Finnix-Enterprises/00001-2-HAR-A-01/README.md

# 00001-2-HAR-A-01
Loan Scam buster Device
