Finnix-Enterprises/00001-2-HAR-A-01/PCB_Deliverables/3-PDF/BD-00001-A-01.pdf

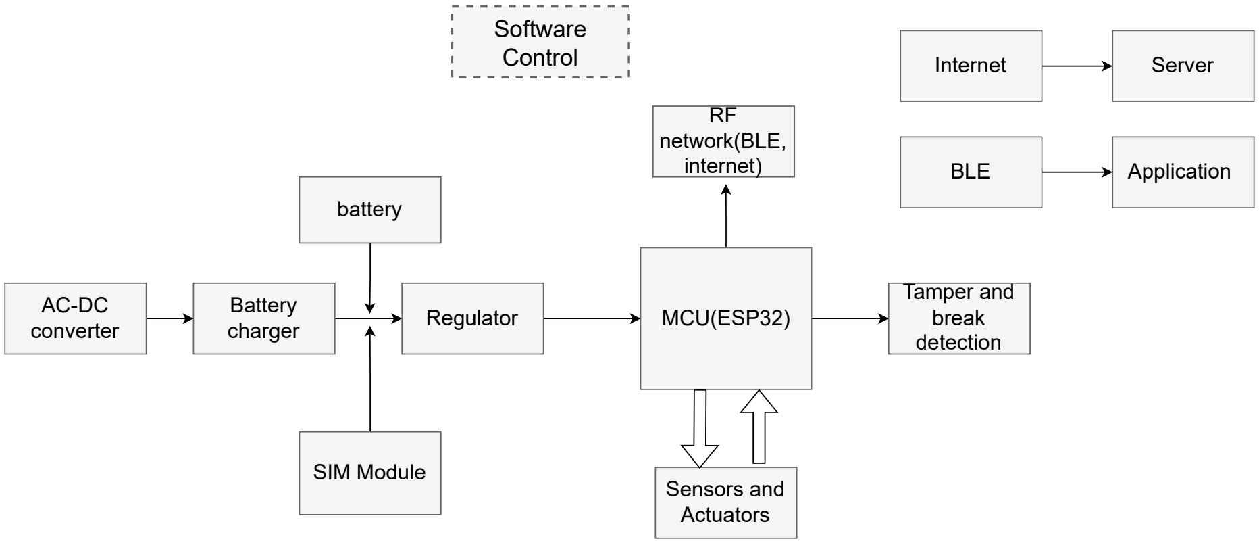
[picture p8: figure]
Software Control; RF network(BLE,; internet); BLE; Application; SIM Module; Sensors and Actuators; Regulator; MCU(ESP32) Battery; charger; battery; AC-DC converter; Tamper and break detection; Internet; Server
