Finnix-Enterprises/00001-2-HAR-A-01/PCB_Deliverables/3-PDF/STACK-00001-A-01.pdf

| A | B | C | D | E | F
4 | | | | | | | 4

## PCB LAYER STACK

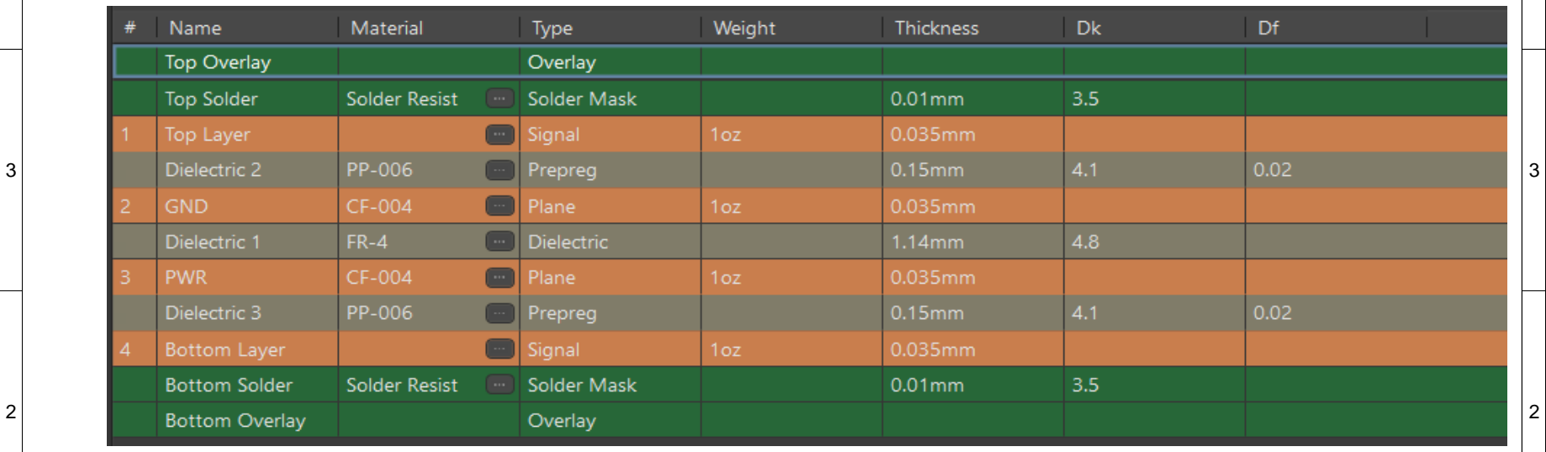
[picture p9: figure]

CLIENT

DRAWING NUMBER:

DRAWN BY: | Varun
DATE: | 27-09-2024 | REVISION NO: | A-
A | B | C | D | E | F
1 | 1 PCB Layer Stack
TBD | Altos Engineers Pvt. Ltd
| Plot No 34, Pace City I, Sector 37, Gurugram, Haryana 122001, India

### 1-2-HAR-A-

COPYRIGHT OF MEL 2017
