Finnix-Enterprises/00001-2-HAR-A-01/00001-2-HAR-A-01/Project Outputs for 00001-2-HAR-A-01/STACK-1-2-HAR-A-01.pdf

| A | B | C | D | E | F
4 | | | | | | | 4
3 | | | | | | | 3
2 | | | | | | | 2

## PCB LAYER STACK

CLIENT

DRAWING NUMBER:

DRAWN BY: | Varun
DATE: | 9/20/2024 | REVISION NO: | A-
A | B | C | D | E | F
1 | 1 PCB Layer Stack
Altos Engineers Pvt. Ltd
Plot No 34, Pace City I,
Sector 37, Gurugram,
Haryana 122001, India

### 1-2-HAR-A-

COPYRIGHT OF MEL 2017
