Finnix-Enterprises/00001-2-HAR-A-01/PCB_Deliverables/3-PDF/BD.png

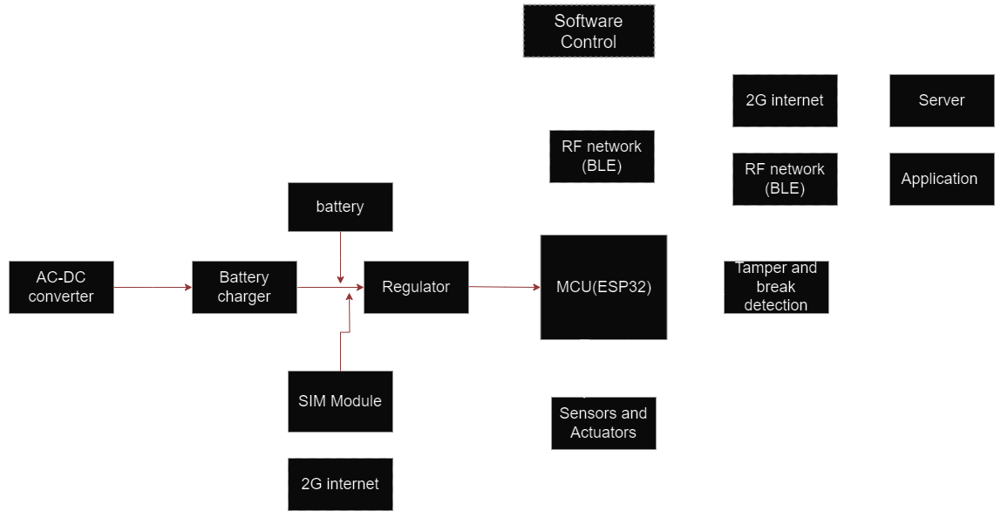
PCB_Deliverables/3-PDF/BD.png
