Finnix-Enterprises/00001-2-HAR-A-01/PCB_Deliverables/3-PDF/P_BOM-00001-A-01.pdf

Client : | Bank | Finnix
Project Name : | #NAME?
PCB File: | 00001-2-HAR-A-01.PrjPcb
PCB Ref: | 1-2-HAR-A-
Project Code : | 1-2-H
Rev Number : | A- | Tel :
Date: | 27-09-2024 | Fax :
Engineer : | Varun | Web :
Designator | FIT/NFIT | Layer | Populated | Checked
C1, C2, C3, C4 | FIT | Top
C5 | FIT | Top
C6 | FIT | Top
C7, C11, C12, C13 | FIT | Top
C8 | FIT | Top
C9, C10 | FIT | Top
D1 | FIT | Top
IR1 | FIT | Top
J2, J3 | FIT | Top
J4, J5 | FIT | Top
J6 | FIT | Top
J7 | FIT | Top
LED1 | FIT | Top
LED2 | FIT | Top
LED3 | NFIT | Top
Q1 | FIT | Top
Q2 | FIT | Top
Q3, Q4 | FIT | Top
R2 | FIT | Top
R3, R15 | FIT | Top
R6 | FIT | Top
R7, R11 | FIT | Top
R8 | FIT | Top
R9 | NFIT | Top
R12, R13, R16, R17, R18, R19, R20, R21, R22, | FIT | Top
RL1, RL2 | FIT | Top
SW1 | FIT | Top
TP1, TP2, TP3, TP4, TP5, TP6, TP7, TP8, TP9, | | Top
U1 | FIT | Top
U2 | FIT | Top
U3 | FIT | Top
U4 | FIT | Top
U5 | FIT | Top
U6 | FIT | Top
U7 | FIT | Top
U8 | FIT | Top
J1 | FIT | Bottom
R1 | FIT | Bottom

Production BOM

R4, R5 | FIT | Bottom
R10 | FIT | Bottom
R14 | FIT | Bottom
