Finnix-Enterprises/00001-2-HAR-A-01/00001-2-HAR-A-01/Project Outputs for 00001-2-HAR-A-01/P_BOM-1-2-HAR-A-01.pdf

Client : | Finnix
Project Name : | Secure appliance disabling system
PCB File: | 00001-2-HAR-A-01.PrjPcb
PCB Ref: | 1-2-HAR-A-
Project Code : | 1-2-H
Rev Number : | A- | Tel :
Date: | 9/20/2024 | Fax :
Engineer : | Varun | Web :

Production BOM

Designator | FIT/NFIT | #Column Name Error:' Layer | Populated | Checked
C1, C2, C3, C4 | FIT
C5 | FIT
C6 | FIT
C7, C11, C12, C13 | FIT
C8 | FIT
C9, C10 | FIT
D1 | FIT
IR1 | FIT
J1 | FIT
J2, J3, J4, J5 | FIT
J6 | FIT
J7 | FIT
LED1 | FIT
LED2 | FIT
LED3 | NFIT
Q1 | FIT
Q2 | FIT
Q3, Q4 | FIT
R1 | FIT
R2 | FIT
R3, R15 | FIT
R4, R5 | FIT
R6 | FIT
R7, R11 | FIT
R8 | FIT
R9 | NFIT
R10 | FIT
R12, R13, R16, R17, R18, R19, R20, R21, R22, | FIT
R14 | FIT
RL1, RL2 | FIT
SW1 | FIT
TP1, TP2
U1 | FIT
U2 | FIT
U3 | FIT
U4 | FIT
U5 | FIT
U6 | FIT

U7 | FIT
U8 | FIT
