Finnix-Enterprises/00001-2-HAR-A-01/00001-2-HAR-A-01/Project Outputs for 00001-2-HAR-A-01/00001-2-HAR-A-01-BOM.xlsm

Sheet: BOM
BOM
Client : | Finnix |  |  |  |  |  |  |  |  | Finnix
Project Name : | Loan Scam buster
PCB File: | 00001-2-HAR-A-01.PrjPcb
PCB Ref: | 1-2-HAR-A-
Project Code : | 1-2-H
Rev Number : | A- |  |  |  |  |  |  |  | Tel : | 9167003166
Date: | 11-10-2024 |  |  |  |  |  |  |  | Fax :
Engineer : | Varun |  |  |  |  |  |  |  | Web : | varunbenningtion16@gmail.com
Designator | Description | Distributor 1 | Distributor 1 Part no. | FIT/NFIT | Footprint | Manufacturer | Manufacturer Part no. | Quantity | Value | Notes
C1, C2, C3, C4 | 1 µF ±10% 10V Ceramic Capacitor X7R 0805 (2012 Metric) | digikey | 490-1695-1-ND | FIT | CAP0805 | Murata Electronics | GRM21BR71A105KA01L | 4 | 1uF 10V
C5 | 100 µF 6.3 V Aluminum Electrolytic Capacitors Radial, Can 2000 Hrs @ 85°C | Digikey | 478-08056D104KAT2ACT-ND | FIT | EC-A_PAN | Panasonic Electronic Components | ECA-0JM101 | 1 | 100uF 6.3V
C6 | 2.2 µF 35 V Aluminum Electrolytic Capacitors Radial, Can 20000 Hrs @ 105°C | Digikey | 493-15889-ND | FIT | CAP_RN_10X12P5_NCH | Nichicon | UPX1V2R2MPD | 1 | 2.2uF 35V
C7, C11, C12, C13 | 0.1 µF ±10% 6.3V Ceramic Capacitor X5R 0805 (2012 Metric) | digikey | 478-08056D104KAT2ACT-ND | FIT | CAP0805 | KYOCERA AVX | 08056D104KAT2A | 4 | 0.1 µF 6.3 V
C8 | 1000 pF ±10% 10V Ceramic Capacitor X7R 0805 (2012 Metric) | Digikey | 399-C0805C102K8RAC7800CT-ND | FIT | CAP0805 | KEMET | C0805C102K8RAC7800 | 1 | 1nF 10 V
C9, C10 | 22 µF ±10% 6.3V Ceramic Capacitor X5R 0805 (2012 Metric) | digikey | 478-08056D104KAT2ACT-ND | FIT | CAP0805 | Samsung Electro-Mechanics | CL21A226KQCLRNC | 2 | 22 µF 6.3 V
D1 | Remote Receiver Sensor 38.0kHz 20m Through Hole | Digikey | 497-5550-1-ND | FIT | SOT-323_2P2X1P35X1P3_STM-M | STMicroelectronics | BAT30CWFILM | 1 | SCHOT 30V 300MA
IR1 | Remote Receiver Sensor 38.0kHz 20m Through Hole | digikey | 751-1227-ND | FIT | TSOP382 | KYOCERA AVX | TSOP38238 | 1 | SENSOR REMOTE REC 38.0KHZ 20M
J1 | Connector Header Through Hole, Right Angle 2 position 0.049" (1.25mm) | Digikey | WM16893-ND | FIT | CON_1053131102 | Molex |  | 1
J2, J3 | 2 Position Wire to Board Terminal Block Horizontal with Board 0.197" (5.00mm) Through Hole | Digikey | 102-6161-ND | FIT | CUI_TB003-500-P02BE | Same Sky | TB003-500-P02BE | 2 | TERMINAL BLOCK, SCREW TYPE, 5.00
J4, J5 | 2 Position Wire to Board Terminal Block Horizontal with Board 0.138" (3.50mm) Through Hole | Digikey | 277-1721-ND | FIT | PHOENIX_1984617 | Phoenix Contact | 1984617 | 2 | TERM BLK 2POS SIDE ENT 3.5MM PCB
J6 | Connector Header Through Hole 3 position 0.100" (2.54mm) | Digikey | S1011EC-03-ND | FIT | CONN_PRPC003SAAN-RC_SUL | Sullins Connector Solutions | PRPC003SAAN-RC | 1
J7 | Connector Header Through Hole 4 position 0.100" (2.54mm) | Digikey | 609-3255-ND | FIT | Amphenol_FCI_0_MFG | Amphenol ICC (FCI) | 68000-204HLF | 1 | CONN HEADER VERT 4POS 2.54MM
LED3 | Standard LEDs - SMD Super Red, 633nm 224mcd, 20mA | Mouser | 720-LSM676-Q2S1-1-Z | NFIT | LEDM2214X140N | ams OSRAM | LS M676-Q2S1-1-Z | 1 | 2.3 V 30mA
Q1 | P-Channel 20 V 2.5A (Ta) 800mW (Ta) Surface Mount SOT-23-3 | Digikey | BC557ATACT-ND | FIT | TO-92-3L_5P33X5P2_ONS | onsemi | BC557ATA | 1 | BJT PNP 45V 0.1A
Q2 | Bipolar (BJT) Transistor NPN 30 V 100 mA 300MHz 500 mW Through Hole TO-92-3 | Digikey | 2156-BC548-FS-ND | FIT | TO-92-3L_5P33X5P2_ONS | Fairchild Semiconductor | BC548 | 1 | TRANS NPN 30V 0.1A
Q3, Q4 | P-Channel 20 V 2.5A (Ta) 800mW (Ta) Surface Mount SOT-23-3 | digikey | DMG2301U-7DICT-ND | FIT | SOT23_DMG2301U_DIO | Diodes Incorporated | DMG2301U-7 | 2 | P-Channel 20 V 2.5A
R6 | 1 kOhms ±5% 0.125W, 1/8W Chip Resistor 0805 (2012 Metric) Automotive AEC-Q200 Thick Film | Digikey | 10-ERA-6AEB3830VCT-ND | FIT | RES0805 | Panasonic Electronic Components | P1.0KACT-ND | 1 | 1K
R7, R11 | 560 Ohms ±0.1% 0.125W, 1/8W Chip Resistor 0805 (2012 Metric) Automotive AEC-Q200 Thin Film | Digikey | P560DACT-ND | FIT | RES0805 | Panasonic Electronic Components | ERA-6AEB561V | 2 | 560
R8 | 330 Ohms ±0.1% 0.125W, 1/8W Chip Resistor 0805 (2012 Metric) Automotive AEC-Q200 Thin Film | Digikey | P330DACT-ND | FIT | RES0805 | Panasonic Electronic Components | ERA-6AEB331V | 1 | 330
R9 | 100 Ohms ±0.1% 0.125W, 1/8W Chip Resistor 0805 (2012 Metric) Automotive AEC-Q200 Thin Film | Digikey | P100DACT-ND | NFIT | RES0805 | Panasonic Electronic Components | ERA-6AEB101V | 1 | 100
R10 | 510 Ohms ±0.1% 0.125W, 1/8W Chip Resistor 0805 (2012 Metric) Automotive AEC-Q200 Thin Film | Digikey | P510DACT-ND | FIT | RES0805 | Panasonic Electronic Components | ERA-6AEB511V | 1 | 510
R12, R13, R16, R17, R18, R19, R20, R21, R22, R23, R24, R25, R26 | 10 kOhms ±0.1% 0.125W, 1/8W Chip Resistor 0805 (2012 Metric) Automotive AEC-Q200 Thin Film | Digikey | P10KDACT-ND | FIT | RES0805 | Panasonic Electronic Components | ERA-6AEB103V | 13 | 10K
R14 | 33 kOhms ±5% 5W Chip Resistor 5329 (13573 Metric), J-Lead Flame Retardant Coating, Safety Metal Film | Digikey | A106035CT-ND | FIT | RES_SMF5_TYCO_TYC | TE Connectivity Passive Product | SMF533KJT | 1 | 33K
R15 | 27 kOhms ±5% 0.125W, 1/8W Chip Resistor 0805 (2012 Metric) Automotive AEC-Q200 Thick Film | Digikey | P27KACT-ND | FIT | RES0805 | Panasonic Electronic Components | ERJ-6GEYJ273V | 1 | 27K
R27, R28 | 100 Ohms ±5% 0.125W, 1/8W Chip Resistor 0805 (2012 Metric) Automotive AEC-Q200 Thick Film | Digikey | P100ACT-ND | FIT | RES0805 | Panasonic Electronic Components | ERJ-6GEYJ101V | 2 | 100
RL1, RL2 | 5V Trigger Relay Module | Winsource | 340142-SRD-05VDC-SL-C | FIT | RELAY_SRD-05VDC-SL-C | SongLe | SRD-05VDC-SL-C | 2
SW1 | Tactile Switch SPST-NO Top Actuated Through Hole | Digikey | 450-1647-ND | FIT | SW4_1825910-E_TEC | TE Connectivity ALCOSWITCH Switches | 1-1825910-8 | 1
TP1, TP2, TP3, TP4, TP5, TP6, TP7, TP8, TP9, TP10, TP11, TP12, TP13, TP14 |  |  |  |  | TEST_POINT |  |  | 14
U1 | AC to DC Power Supply Module | ElectroncisComp | EC-4693 | FIT | CONV_HLK-10M05 | Hi-link | HLK-10M05 | 1
U2 | 4.2v and 8.4v Dual One/Two Battery Protection Board | ROBU | 62296 | FIT | TP5100_MODULE | Tap ower ASIC | TP5100 | 1 | Charger Module
U3 | Linear Voltage Regulator IC Positive Fixed 1 Output 300mA SOT-23-5 | Digikey | 2129-RP170N331D-TR-FECT-ND | FIT | SOT-23-5SC-74A_PE-SOT-23-5-180326_NMD-M | Nisshinbo Micro Devices Inc. |  | 1
U4 | Counter IC Counter, Decade 1 Element 10 Bit Positive, Negative 16-PDIP | digikey | 296-2037-5-ND | FIT | DIP794W45P254L1969H508Q16 | Texas Instruments | CD4017BE | 1 | IC DECADE COUNTER 10BIT 16DIP
U5 | Current Sensor 20A 1 Channel Hall Effect, Open Loop Bidirectional 8-SOIC (0.154", 3.90mm Width) | Digikey | 620-1190-1-ND | FIT | SOIC127P600X175-8N | onsemi | ACS712ELCTR-20A-T | 1 | SENSOR CURRENT HALL 20A AC/DC
U6 | Optoisolator Transistor with Base Output 5000Vrms 1 Channel 6-DIP | digikey | 58-H11AA1-ND | FIT | DIP762W50P254L730H410Q6 | Isocom Components 2004 LTD | H11AA1 | 1 | 6PIN AC INPUT, SINGLE OPTOCOUPLE
U7 | Bluetooth, WiFi 802.11b/g/n, Bluetooth v4.2 +EDR, Class 1, 2 and 3 Transceiver Module 2.4GHz ~ 2.5GHz Integrated, Trace Surface Mount | Digikey | 1965-ESP32-WROOM-32E-N4CT-ND | FIT | ESP32-WROOM-32E_EXP | Espressif Systems | ESP32-WROOM-32E-N4 | 1 | RF TXRX MOD BT BLE WIFI
U8 | miniature cellular GSM modem | Alibaba |  | FIT | SIM800L-CORE | SIMCOM | - | 1
U9, U10 | Optoisolator Transistor Output 5000Vrms 1 Channel 4-SMD | Digikey | 1855-1014-1-ND | FIT | SOP_PC8171_SCT-M | SHARP/Socle Technology | PC81710NIP1B | 2

Sheet: P_BOM
Production BOM
Client : | Finnix |  |  |  |  |  | Finnix
Project Name : | Loan Scam Buster Device
PCB File: | 00001-2-HAR-A-01.PrjPcb
PCB Ref: | 1-2-HAR-A-
Project Code : | 1-2-H
Rev Number : | A- |  |  |  |  | Tel :
Date: | 11-10-2024 |  |  |  |  | Fax :
Engineer : | Varun |  |  |  |  | Web :
Designator |  | FIT/NFIT | Layer | Populated | Checked
C1, C2, C3, C4 |  | FIT | None, Top
C5 |  | FIT | Top
C6 |  | FIT | Top
C7, C11, C12, C13 |  | FIT | Top
C8 |  | FIT | Top
C9, C10 |  | FIT | Top
D1 |  | FIT | Top
IR1 |  | FIT | Top
J1 |  | FIT | Bottom
J2, J3 |  | FIT | Top
J4, J5 |  | FIT | Top
J6 |  | FIT | Top
J7 |  | FIT | Top
LED3 |  | NFIT | Top
Q1 |  | FIT | Top
Q2 |  | FIT | Top
Q3, Q4 |  | FIT | Top
R6 |  | FIT | Top
R7, R11 |  | FIT | Top
R8 |  | FIT | Top
R9 |  | NFIT | Top
R10 |  | FIT | Bottom
R12, R13, R16, R17, R18, R19, R20, R21, R22, R23, R24, R25, R26 |  | FIT | Top
R14 |  | FIT | Bottom
R15 |  | FIT | Top
R27, R28 |  | FIT | Top
RL1, RL2 |  | FIT | Top
SW1 |  | FIT | Top
TP1, TP2, TP3, TP4, TP5, TP6, TP7, TP8, TP9, TP10, TP11, TP12, TP13, TP14 |  |  | Top
U1 |  | FIT | Top
U2 |  | FIT | Bottom
U3 |  | FIT | Top
U4 |  | FIT | Top
U5 |  | FIT | Top
U6 |  | FIT | Top
U7 |  | FIT | Top
U8 |  | FIT | Top
U9, U10 |  | FIT | Top

Sheet: SPEC
PCB Name | 1-2-HAR-A- | Date | 11-10-2024
Contact | Varun
Contact Email | varunbennington16@gmail.com
 |  |  | Dimensions
Number of layers |  | 2 | N/A
Maximum PCB Dimensions |  | 140.67 x 95 | mm
Laminate Material |  | Standard FR-4 Epoxy Glass | N/A
 | Finished Board Thickness | 1.6 | mm
Minimum Track Width |  | 0.15 | mm
Minimum Track Clearance |  | 0.15 | mm
Smallest Drill Diameter |  | 0.3 | mm
Minimum Distance Between Hole Centres |  | 0.254 | mm
Minimum Width of Surface Mount Pads |  | N/A | mm
Min Distance Between Centres of SMT Pads |  | N/A | mm
Soldermask Colour |  | Green | N/A
Number of Soldermask Sides |  | 2 | sides
Soldermask Type |  | LPI | N/A
Silkscreen Colour |  | White | N/A
Silkscreen Sides |  | 2 | sides
Copper Weight Inner Layers |  | 1 | Oz
Copper Weight Outer Layers |  | 1 | Oz
Surface Plating |  | ENIG | N/A
Electrical Test Required |  | Yes | N/A
Additional Notes:
Please record any additional requirements here
Unless Otherwire Specified:
Drilling and Plating | All holes with terminal lands are plated through holes.
 | Hole sizes specified above are finished sizes, ±0.003 tolerance
 | Plated through holes have minimum 0.001" plating thickness.
 | Hole centres to be ±0.003" from true centre of lands.
 | There shall be no breakout of holes from lands.
Finish | Silkscreen or soldermask not allowed on surface mount or through hole pads.
Workmanship | General acceptability per IPC-A-600G class II.
 | Bow and twist maximum of 0.007" per inch.

Sheet: STACK
 | A | B |  | C | D | E | F
4 |  |  |  | PCB LAYER STACK |  |  |  | 4
3 |  |  |  |  |  |  |  | 3
2 |  |  |  |  |  |  |  | 2
1 |  |  |  |  |  |  |  | 1
 |  | PCB Layer Stack | CLIENT | Finnix |  |  | Altos Engineers Pvt. Ltd Plot No 34, Pace City I, Sector 37, Gurugram, Haryana 122001, India
 |  |  | DRAWING NUMBER: | 1-2-HAR-A-
 |  |  | DRAWN BY: | Varun
 |  |  | DATE: | 11-10-2024 | REVISION NO: | A-
 |  |  | COPYRIGHT OF MEL 2017
 | A | B |  | C | D | E | F

Sheet: SPEC options
Property | Option
Number of layers | 2 | 4 | 6 | 8 | 10 | 12 | 14
Laminate Material | Standard FR-4 Epoxy Glass | Flexible | Rigid-flex
Finished Board Thickness | 0.8 | 1.6
Minimum Track Width | 0.15 | 0.3
Minimum Air Gap | 0.15 | 0.3
Smallest Drill Diameter | 0.2 | 0.25 | 0.3 | 0.6 | 0.9
Minimum Distance Between Hole Centres
Minimum Width of Surface Mount Pads
Min Distance Between Centres of SMT Pads
Soldermask Colour | Green | Black | Red | Blue | White
Number of Soldermask Sides | 1 | 2
Soldermask Type | LPI
Silkscreen Colour | White | Black | Yellow
Silkscreen Sides | 1 | 2
Copper Weight Inner Layers | 0.5 | 1 | 2
Copper Weight Outer Layers | 0.5 | 1 | 2
Surface Plating | HASL | ENIG | Hard Gold | Immersion Tin | OSP
Electrical Test Required | No | Yes
Dimension Drop Down Box | mm | mils
