Finnix-Enterprises/00001-2-HAR-A-01/PCB_Deliverables/3-PDF/SCH-00001-A-01.PDF

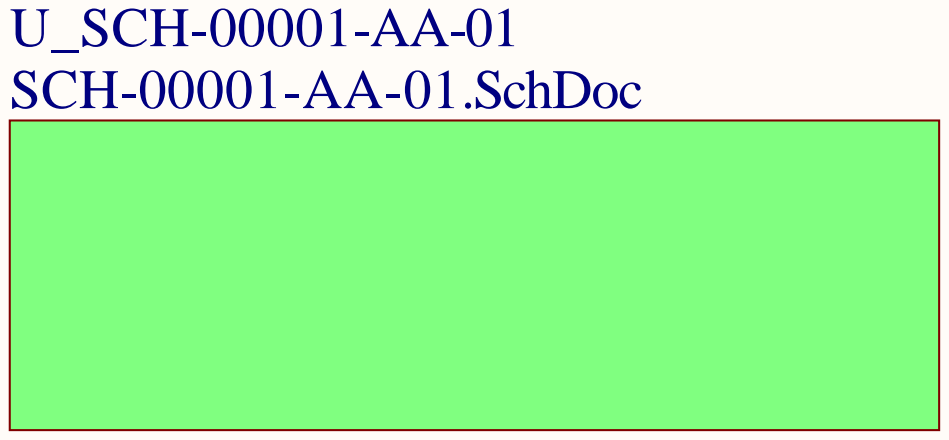
[picture p11: page 1]

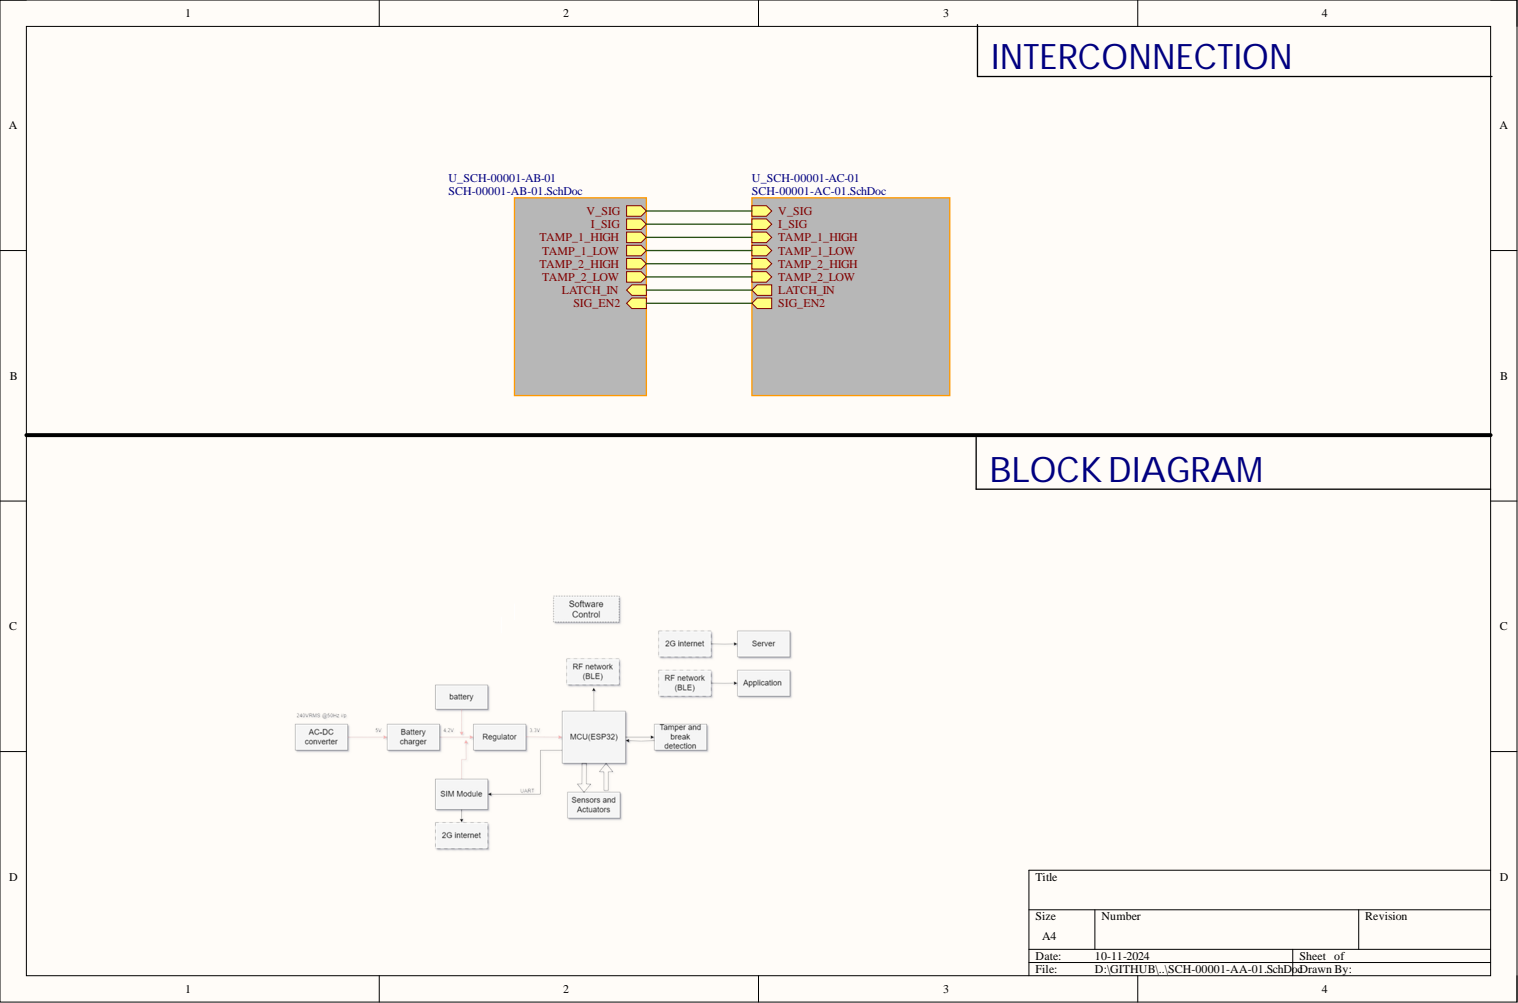
[picture p12: page 2]

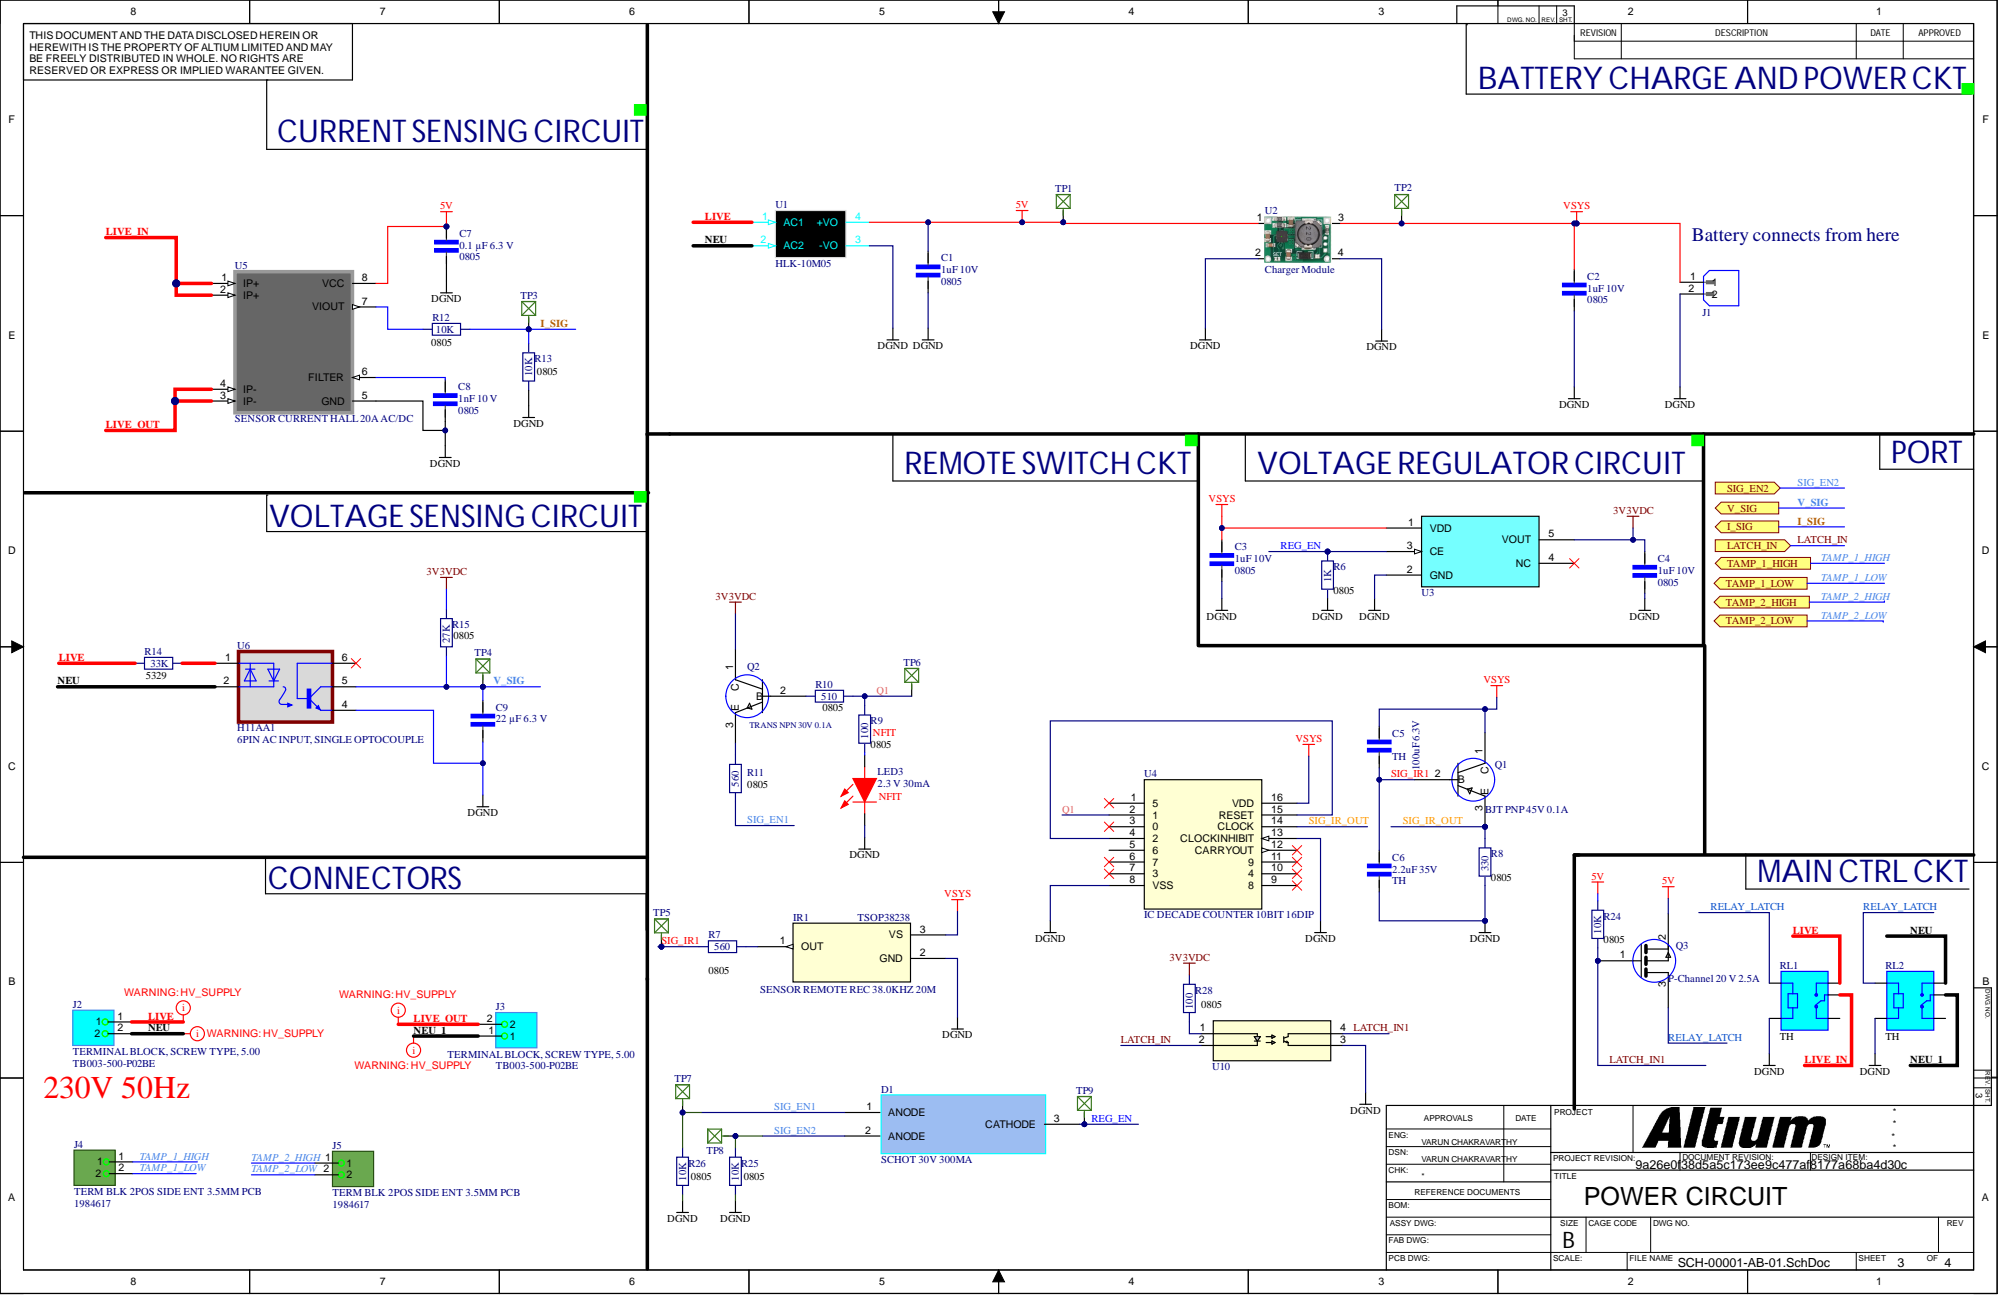
[picture p13: page 3]

DWG . N O . | R E V | . S H T.

T H IS DOC U MEN T AN D T HE D ATA D ISCLOSED HEREI N OR HEREW I T H IS T HE PROPER TY OF ALT I U M LI M I TED AN D M AY BE F REELY D IST R IBU TED I N W HOLE. NO R IGH TS ARE RESERVED OR EXPRESS OR I MPLIED WARAN TEE GIVEN . | | T P 2 T P 1 | | REVISI O N | DESCRIPTI O N | DATE | APPROVED

BATTERY CHARGE AND POWER CK

REV. SHT. DWG. NO.

DATE | PRO JECT | **** APPROVALS

ENG : VARUN CHAKRA VARTHY

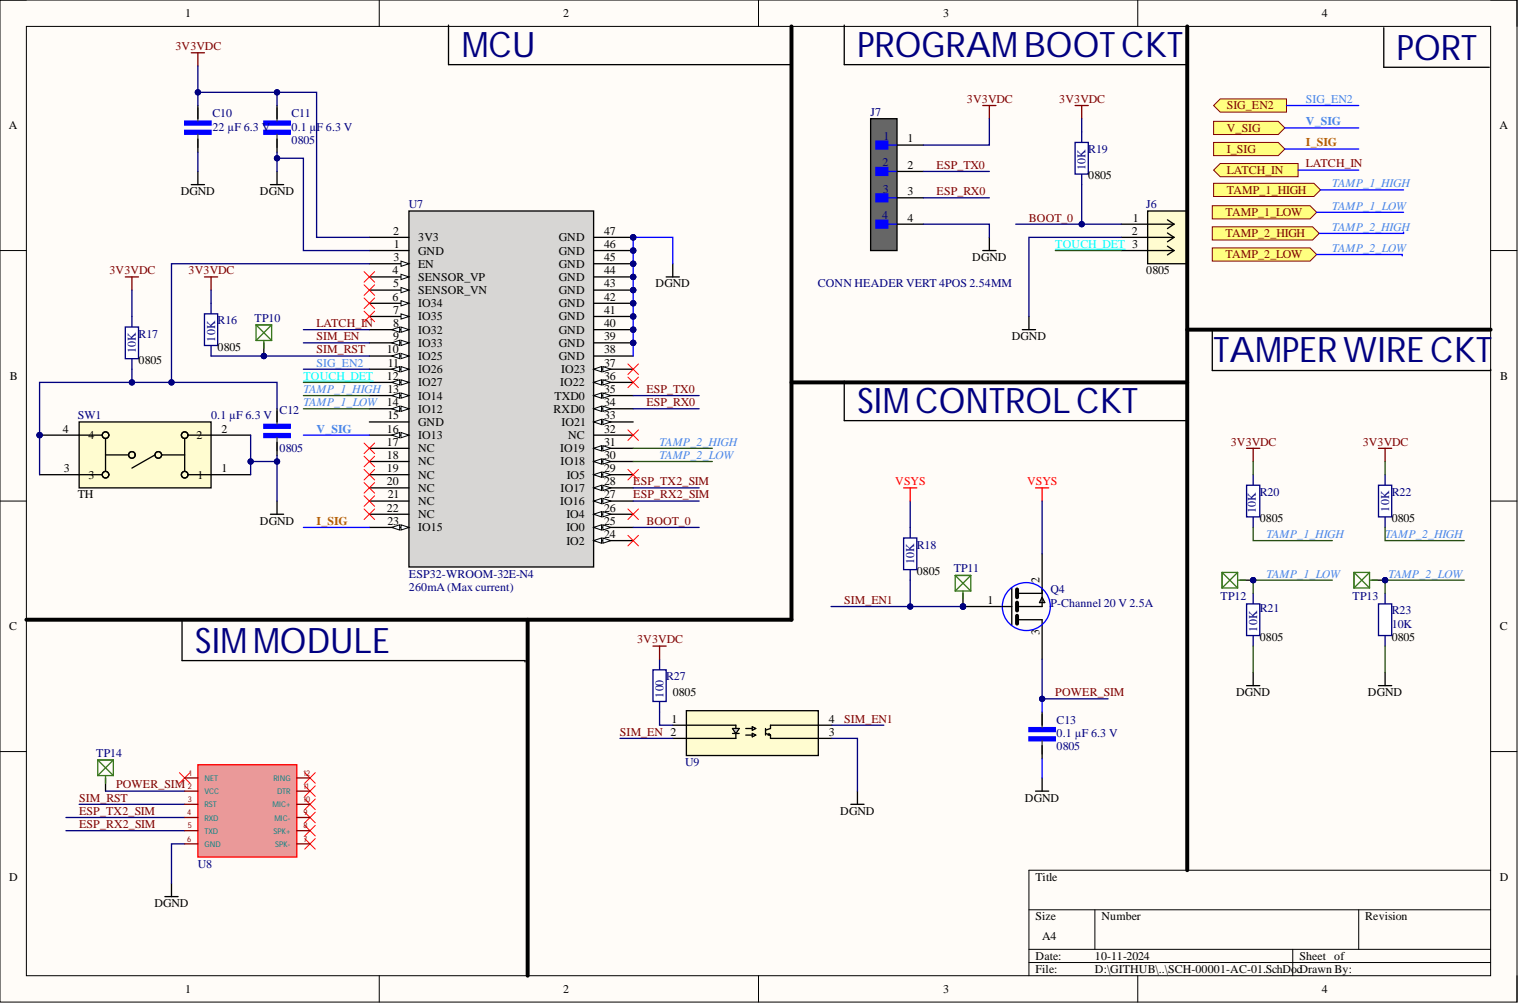
[picture p14: page 4]
