Finnix-Enterprises/00001-2-HAR-A-01/PCB_Deliverables/3-PDF/PCB-00001-A-01.PDF

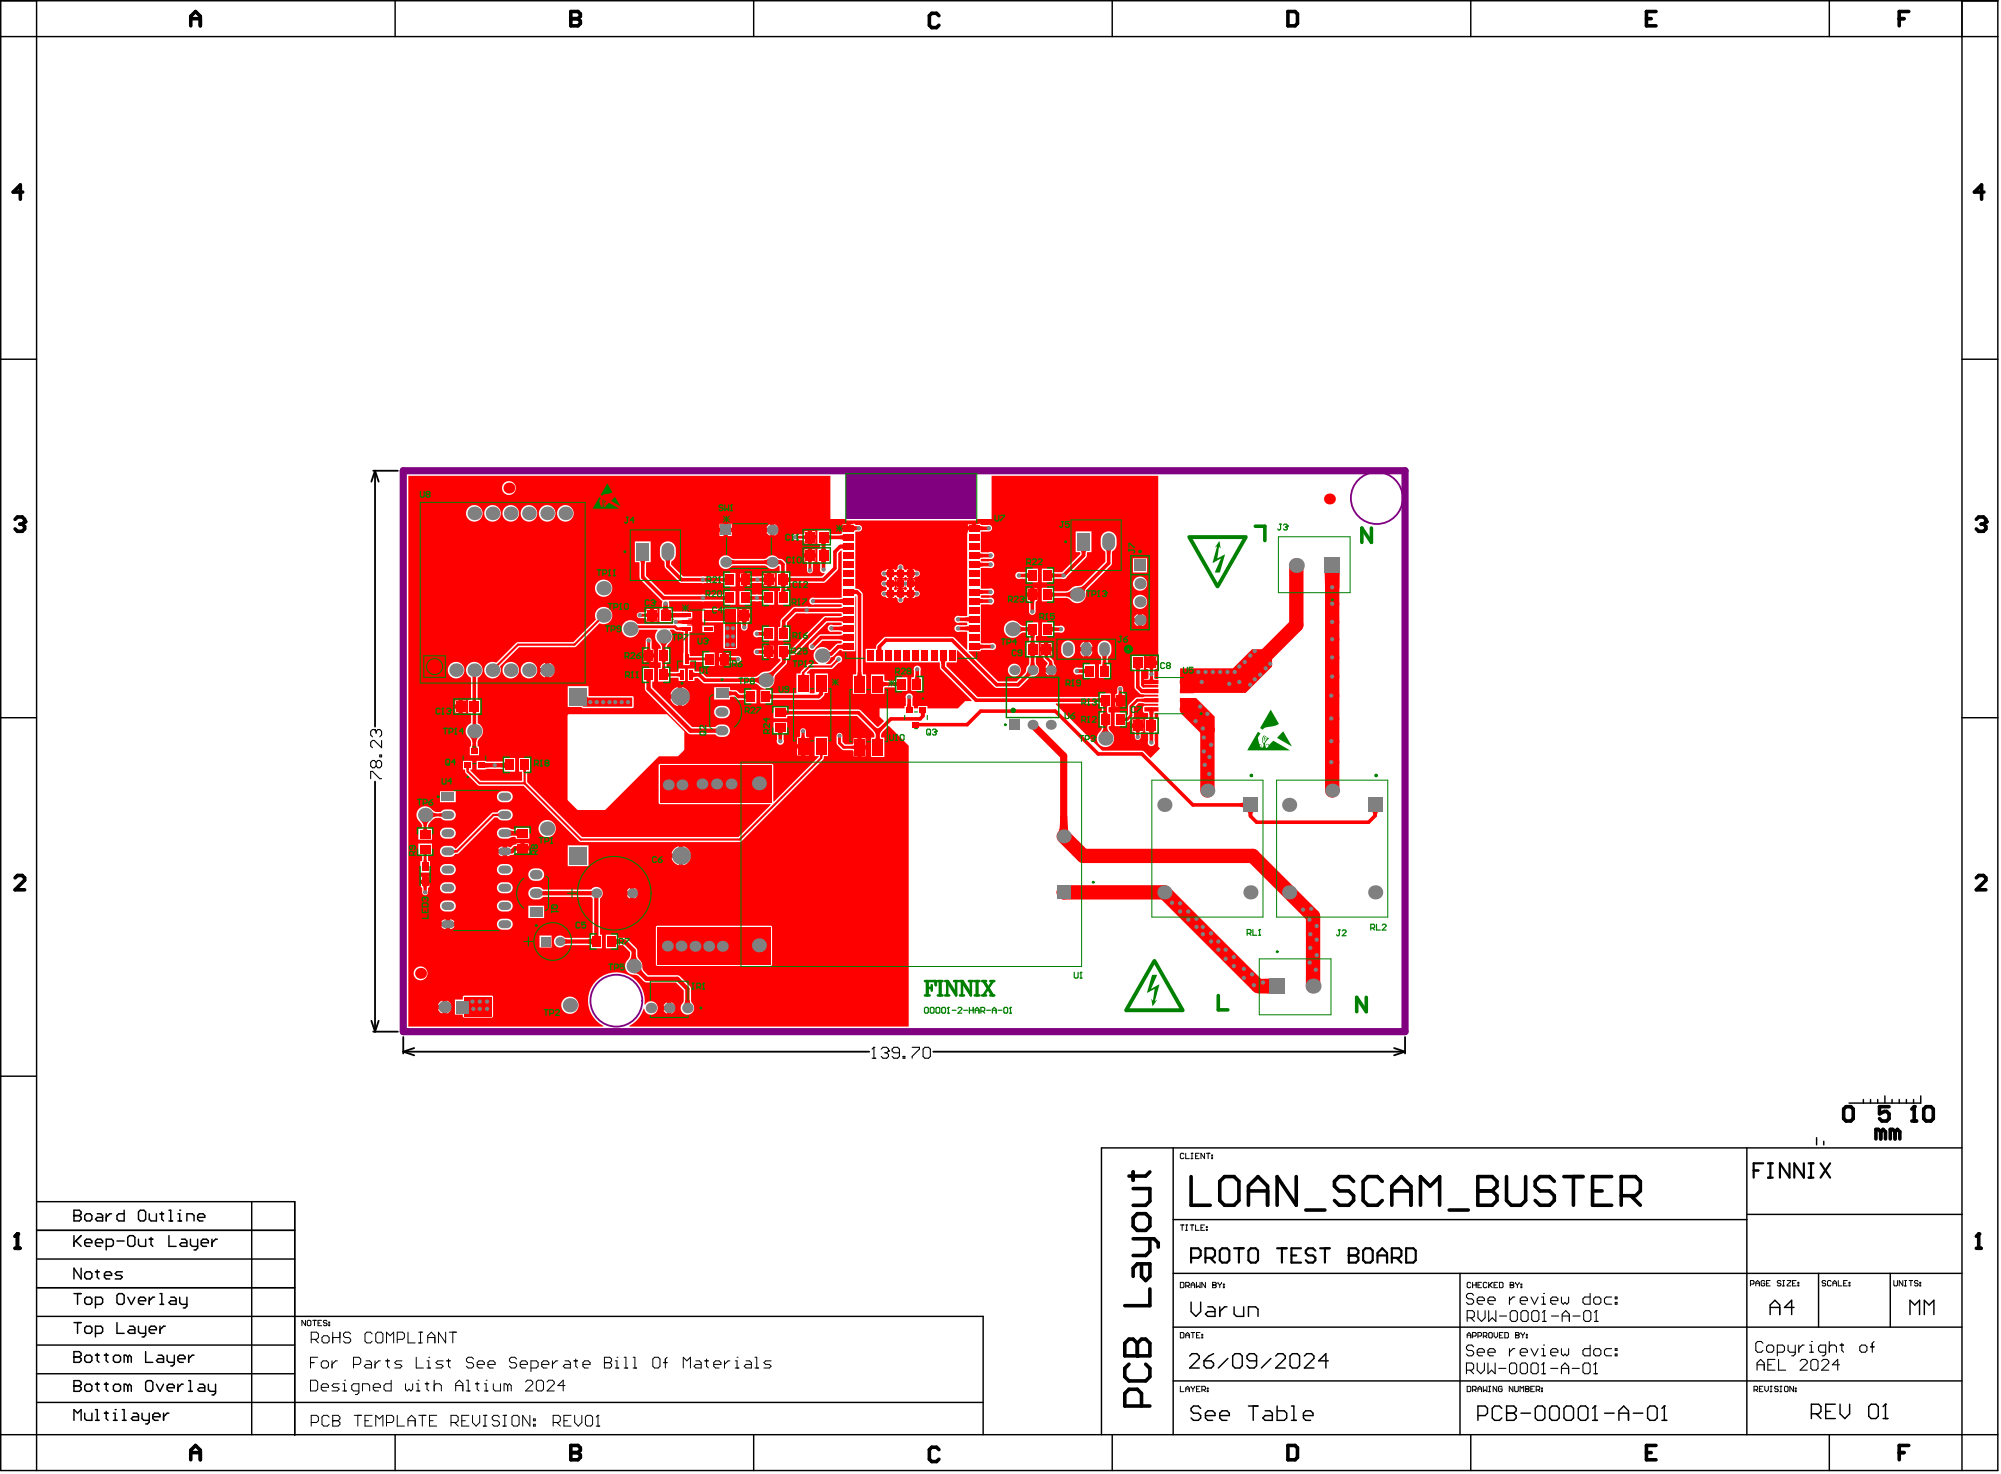
[picture p15: page 1]

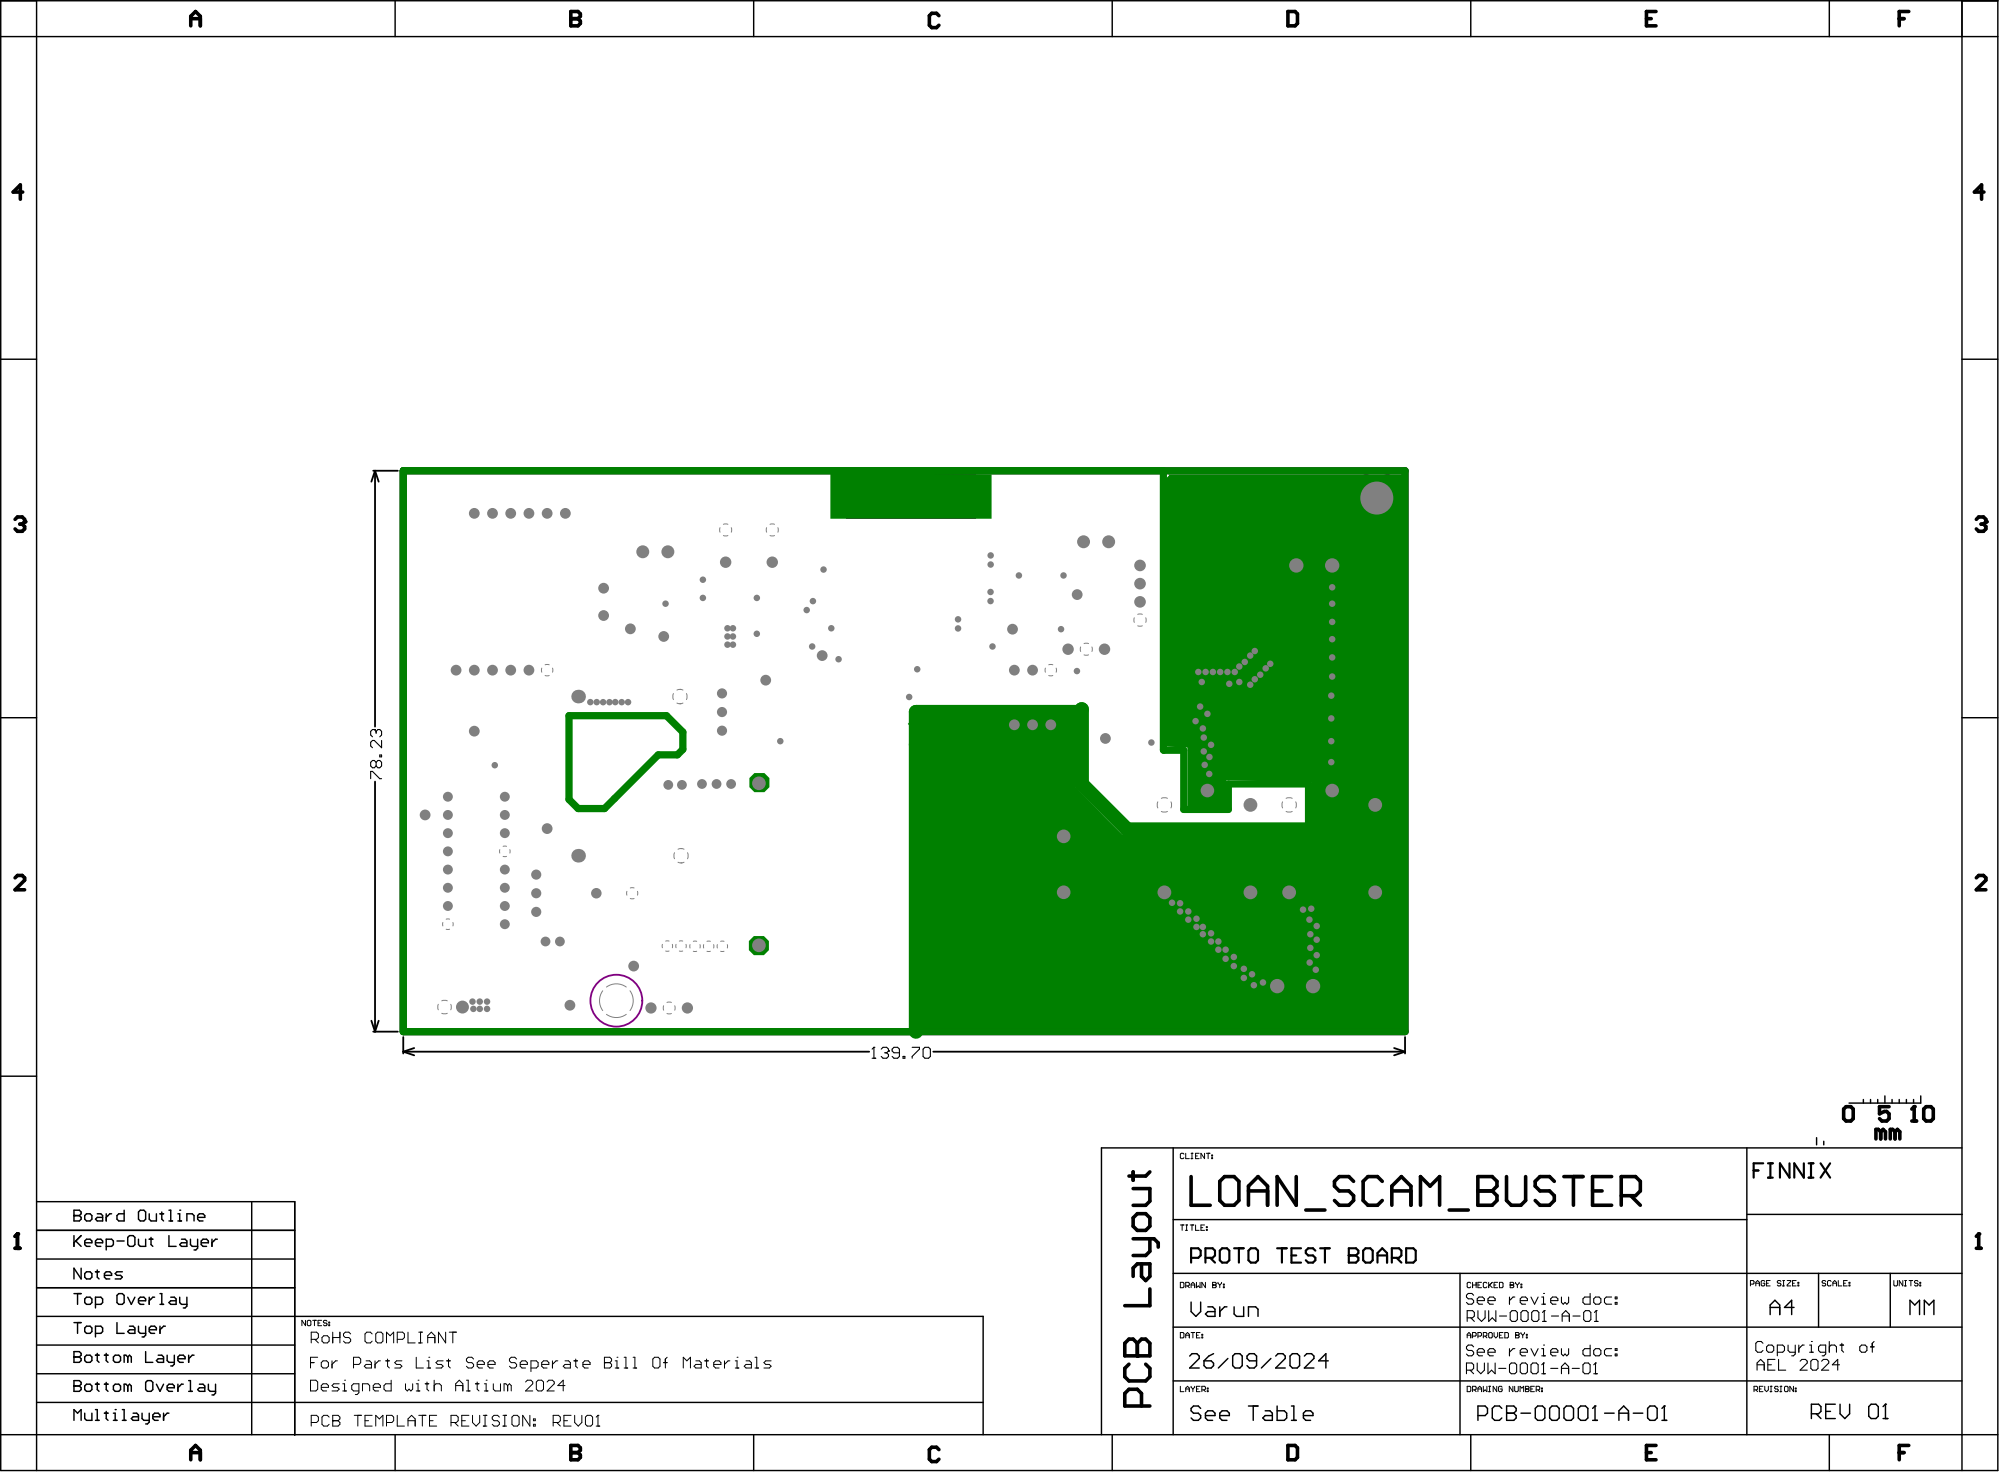
[picture p16: page 2]

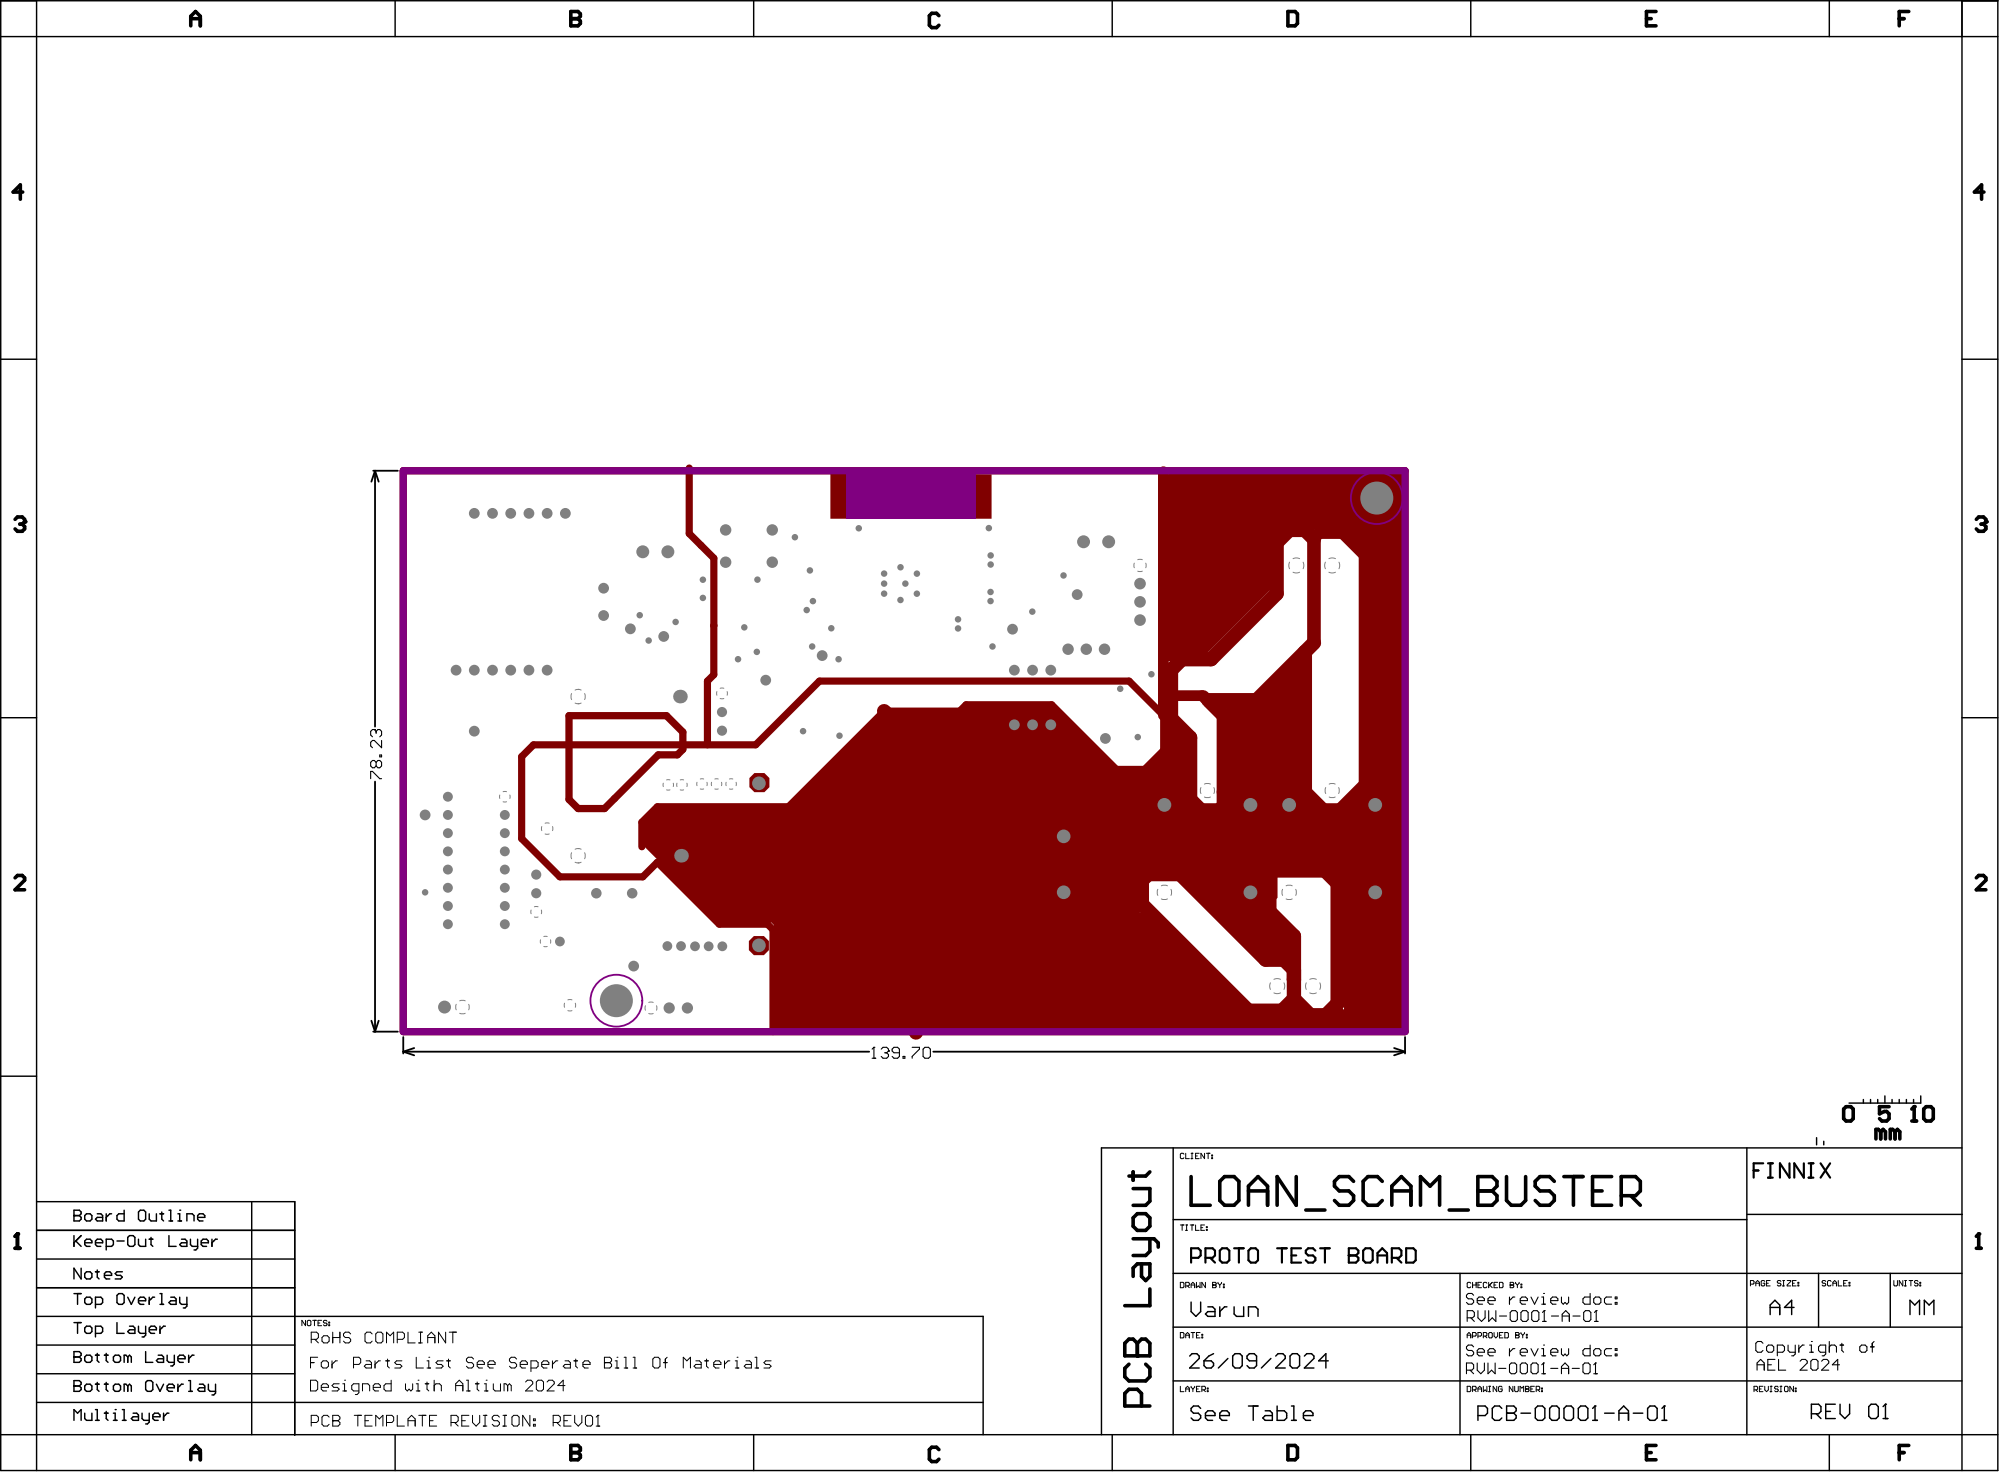
[picture p17: page 3]

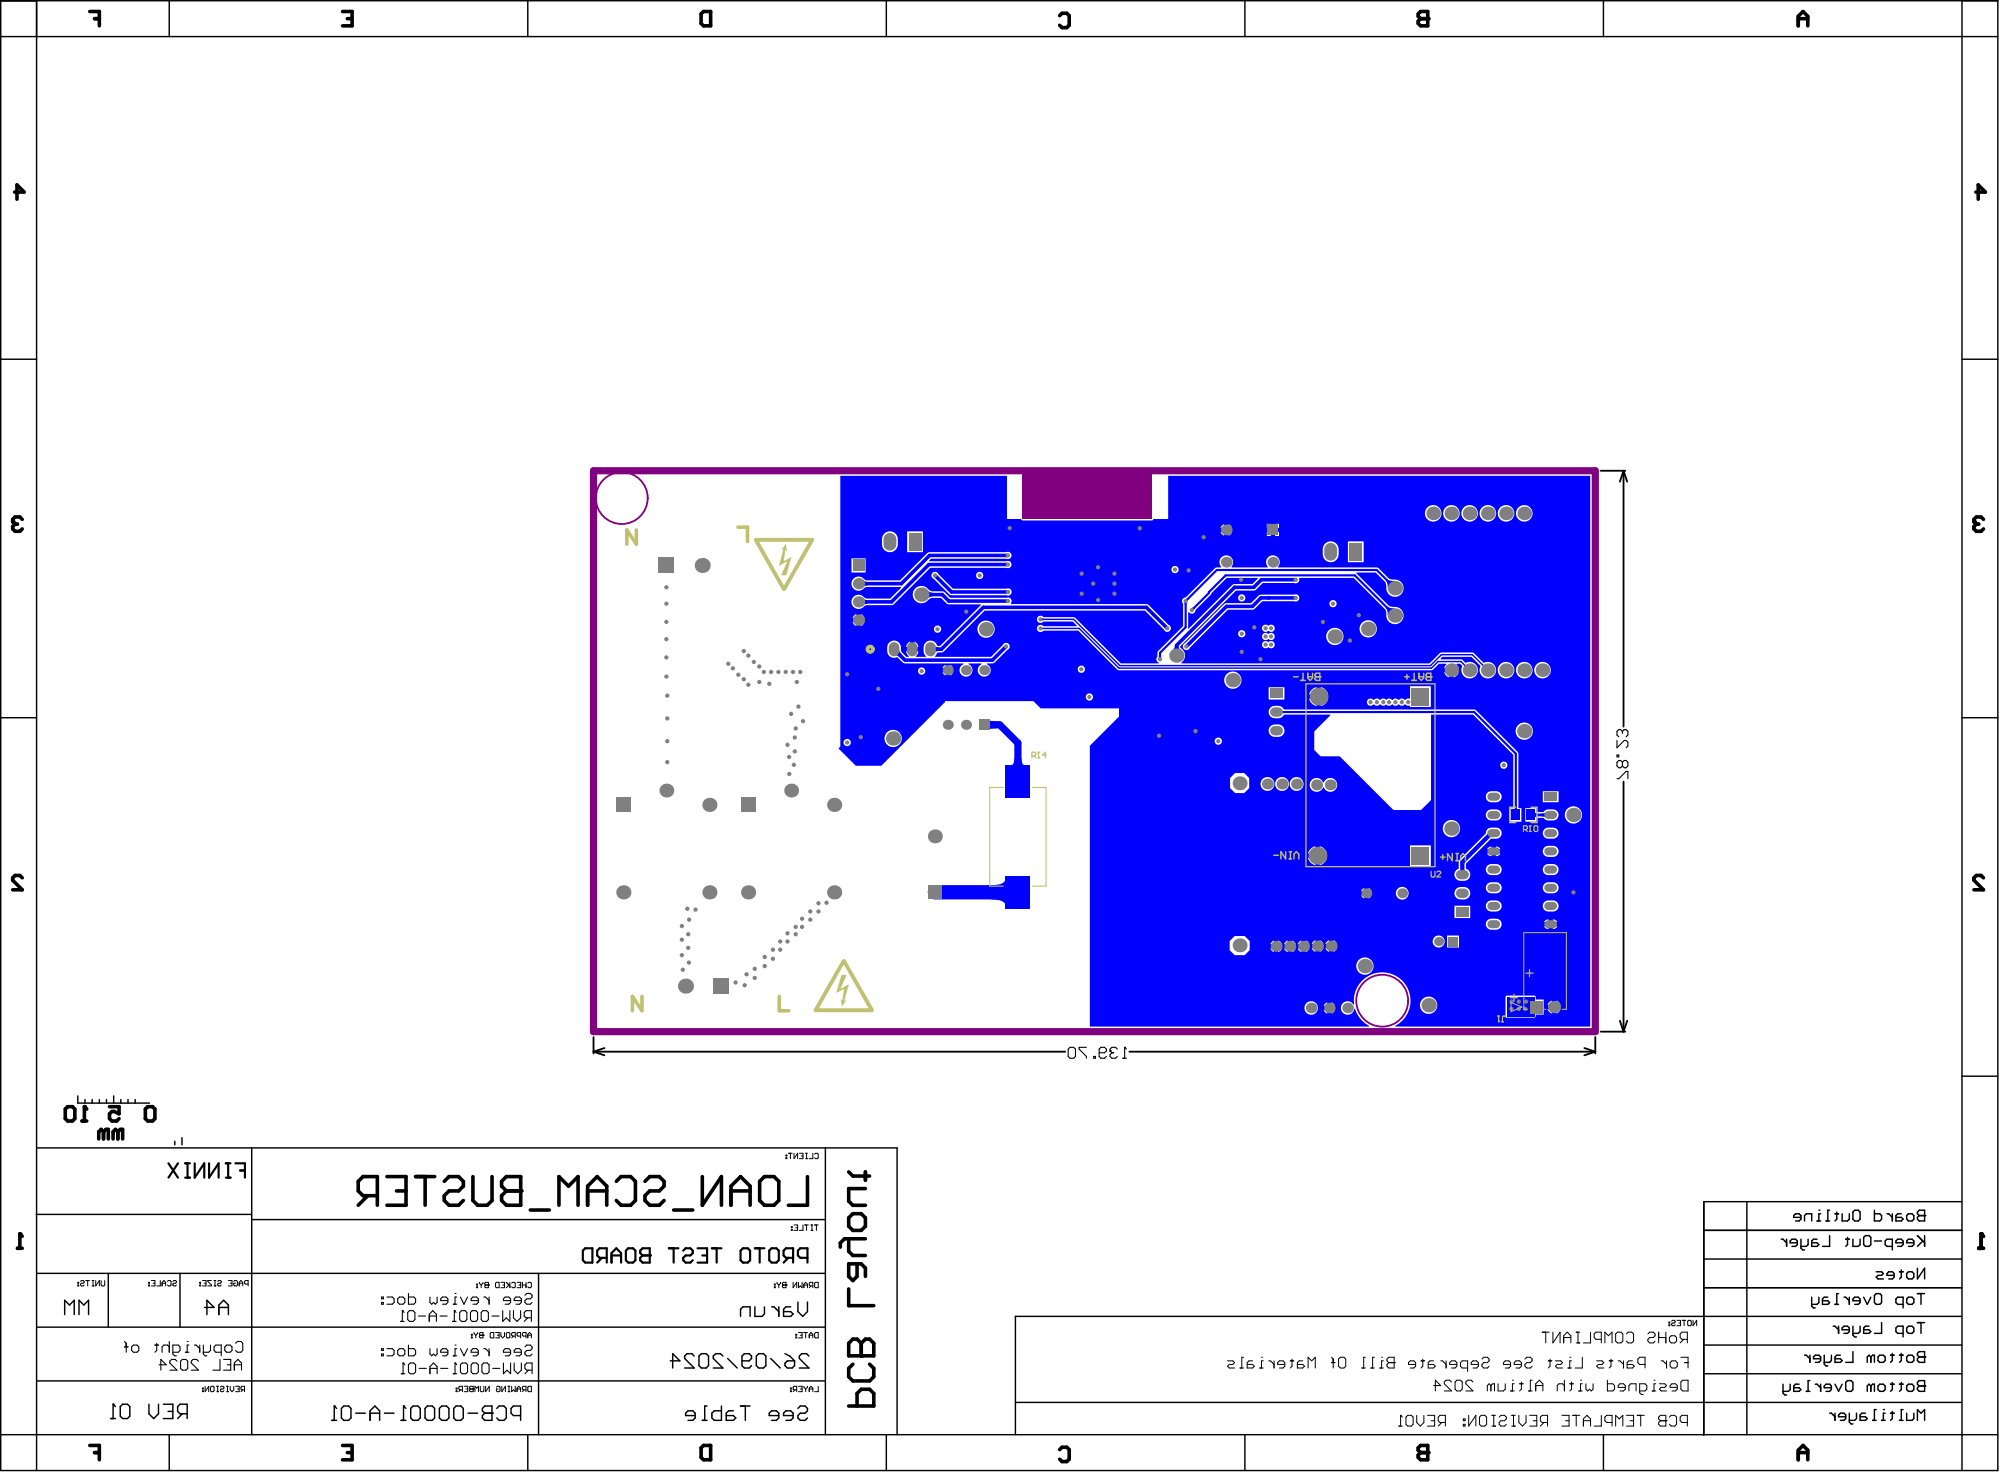
[picture p18: page 4]

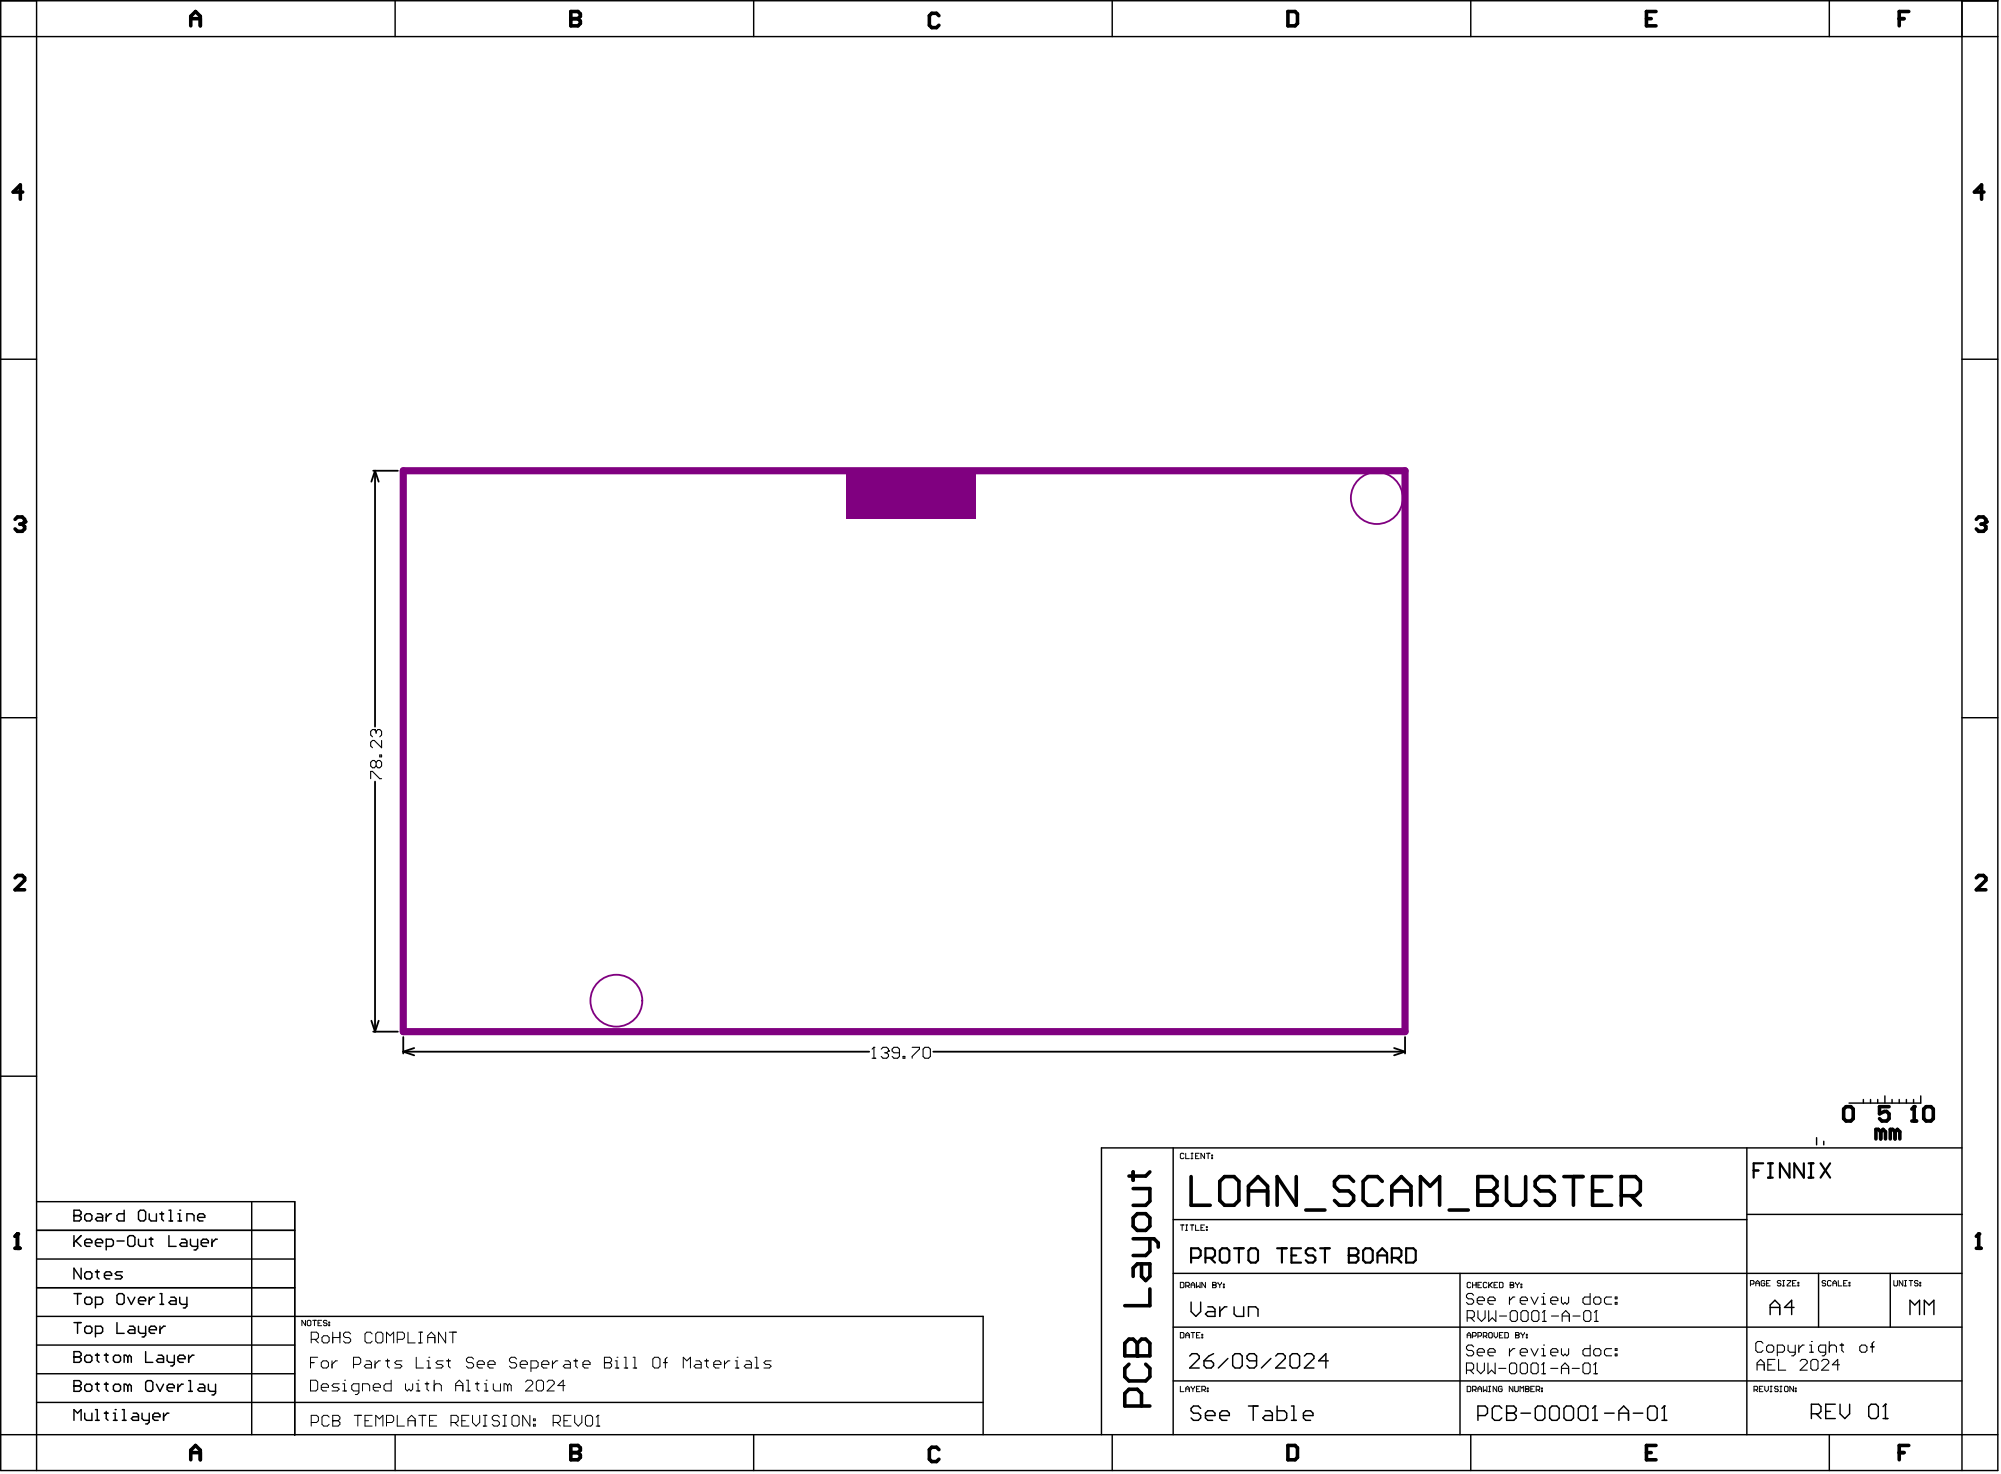
[picture p19: page 5]
