Finnix-Enterprises/00001-2-HAR-A-01/(list of files, drawings)

Other design files:
00001-2-HAR-A-01/00001-2-HAR-A-01.PrjPcb
00001-2-HAR-A-01/PCB/PCB-00001-A-01.PcbDoc
00001-2-HAR-A-01/Schematic/SCH-00001-A-01.SchDoc
00001-2-HAR-A-01/Schematic/SCH-00001-AA-01.SchDoc
00001-2-HAR-A-01/Schematic/SCH-00001-AB-01.SchDoc
00001-2-HAR-A-01/Schematic/SCH-00001-AC-01.SchDoc
Sim_Models/Remote_Turn_on_CKT/Project Backups/REMOTE_SWITCH_ON_CKT_SIM [20241013, 13-54-58].pdsprj
Sim_Models/Remote_Turn_on_CKT/Project Backups/REMOTE_SWITCH_ON_CKT_SIM [20241013, 18-09-26].pdsprj
Sim_Models/Remote_Turn_on_CKT/Project Backups/REMOTE_SWITCH_ON_CKT_SIM [20241013, 18-10-20].pdsprj
Sim_Models/Remote_Turn_on_CKT/Project Backups/REMOTE_SWITCH_ON_CKT_SIM [20241013, 18-10-21].pdsprj
Sim_Models/Remote_Turn_on_CKT/Project Backups/REMOTE_SWITCH_ON_CKT_SIM [20241013, 18-10-23].pdsprj
Sim_Models/Remote_Turn_on_CKT/Project Backups/REMOTE_SWITCH_ON_CKT_SIM [20241013, 21-20-49].pdsprj
Sim_Models/Remote_Turn_on_CKT/REMOTE_SWITCH_ON_CKT_SIM.pdsprj
