Finnix-Enterprises/00001-2-HAR-A-01/(commit log)

2024-09-27 Version 01 commit
    [00001-2-HAR-A-01.PrjPcb, 00001-2-HAR-A-01.xlsm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]
2024-09-27 generated BOM for the Hardware
    [BOM-00001-A-01.xlsm, BOM_template.xlsm, PCB-00001-A-01.PcbDoc]
2024-09-27 Re generate Gerber
    [00001-2-HAR-A-01.PrjPcb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]
2024-10-01 Addtion of further documents with reiteration of Board
    [PCB-00001-A-01.PcbDoc, SCH-00001-AA-01.SchDoc, SCH-00001-AC-01.SchDoc]
2024-10-06 hardware update 0.8
    making changes in the PCB :
    adding different battery connector
    still need to DRC it
    [PCB-00001-A-01.PcbDoc, SCH-00001-AB-01.SchDoc]
2024-10-07 Hardware update 0.9
    1.added 4 new components
    2.Reworked the design
    3. Ran DRC error: Successful/ no errors
    [PCB-00001-A-01.PcbDoc, SCH-00001-AB-01.SchDoc, SCH-00001-AC-01.SchDoc]
2024-10-08 Hardware Update 1.0
    1.finished with adding feducials
    2.holes added for isolation
    3. generated output files: no DRC error
    [00001-2-HAR-A-01-01.xlsm, 00001-2-HAR-A-01.PrjPcb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]
2024-10-11 Hardware update 1.1
    1,chagned the circuit and added the battery charger
    2.Ran DRC , no errors
    3. Generated Output successfully
    4. Need to update BOM
    [00001-2-HAR-A-01.PrjPcb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]
2024-10-13 Hardware Update :1.2
    1. Edited and generated Gerber with no errors
    [00001-2-HAR-A-01-BOM.xlsm, 00001-2-HAR-A-01.PrjPcb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]
2024-10-15 hardware update 1.3
    1. performing DFM check
    [00001-2-HAR-A-01.PrjPcb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]
